icl-rocketry/Engine-Electronics/Chad/Software/README.md

# Ricardo-Gateway
Firmware for Ricardo Gateways
