icl-rocketry/Engine-Electronics/Chad/Hardware/Actuators Board.kicad_pcb

## KiCad design Chad/Hardware/Actuators Board.kicad_pcb (2022-09-09)

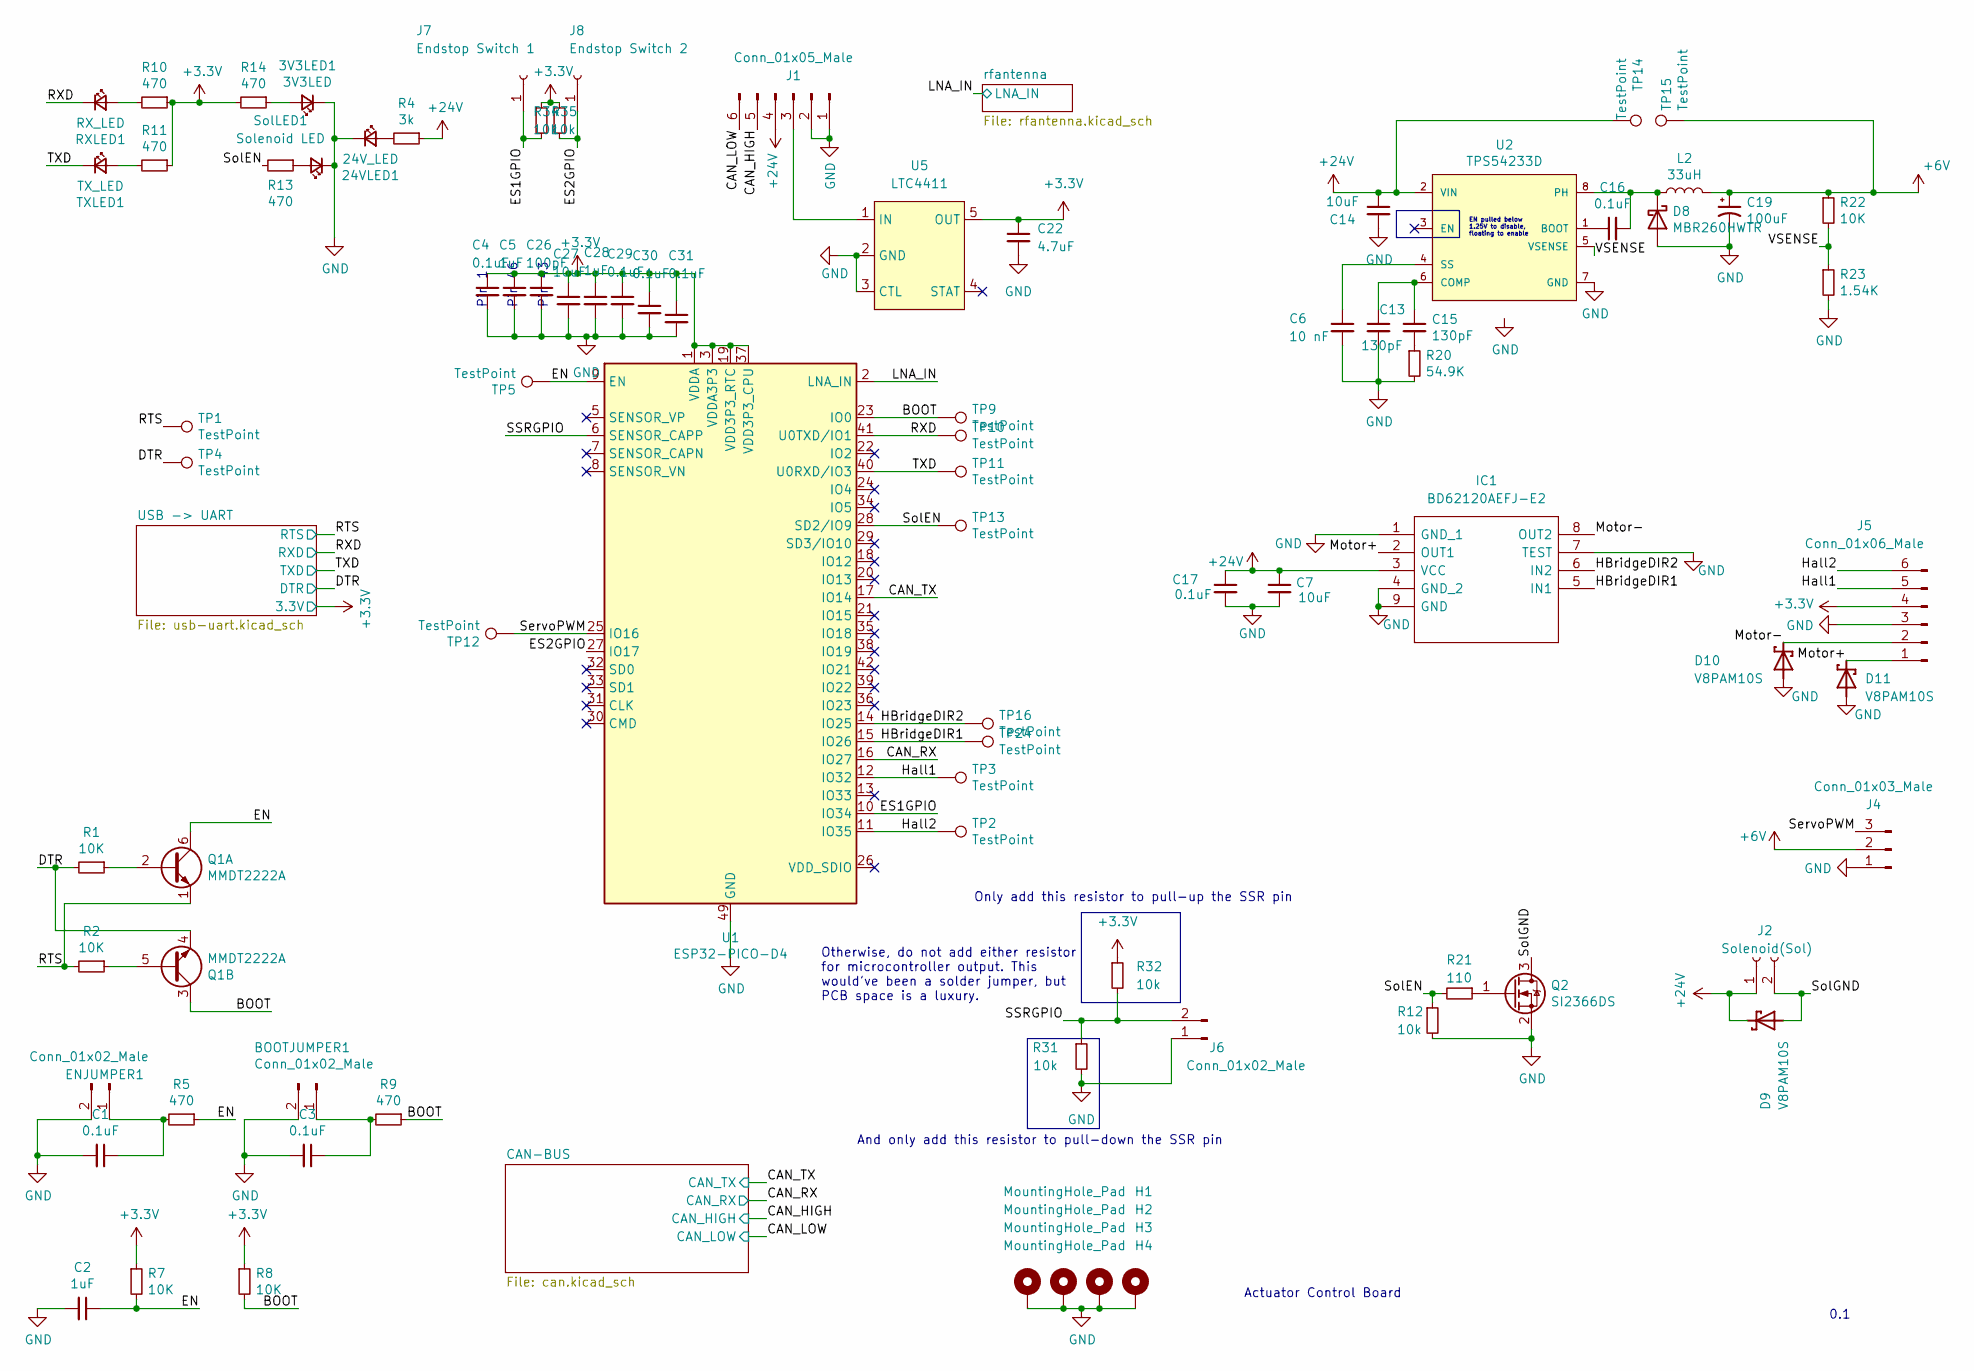
[picture p1: schematic Actuators Board.kicad_sch]

Parts:
3V3LED1: 3V3LED; LED_0603_1608Metric
24VLED1: 24V_LED; LED_0603_1608Metric
BOOTJUMPER1: Conn_01x02_Male; PinHeader_1x02_P2.54mm_Vertical
C1, C3, C4, C16, C17, C29, C30, C31: 0.1uF; C_0603_1608Metric
C2, C5, C28: 1uF; C_0603_1608Metric
C6: 10 nF; C_0603_1608Metric
C7, C14: 10uF; C_1210_3225Metric
C13, C15: 130pF; C_0603_1608Metric
C19: 100uF; CP_Elec_5x5.9
C22: 4.7uF; C_0603_1608Metric
C26: 100pF; C_0603_1608Metric
C27: 10uF; C_0603_1608Metric
D8: MBR260HWTR; D_SOD-123
D9, D10, D11: V8PAM10S; DIO_V3PAN50-M3_I; PARTREV 20-Oct-16
ENJUMPER1: Conn_01x02_Male; PinHeader_1x02_P2.54mm_Vertical
H1, H2, H3, H4: MountingHole_Pad; MountingHole_3.2mm_M3_DIN965_Pad
IC1: BD62120AEFJ-E2; SOIC127P600X100-9N; Manufacturer_Part_Number BD62120AEFJ-E2; Mouser Part Number 755-BD62120AEFJ-E2
J1: Conn_01x05_Male; Molex_Mini-Fit_Jr_5566-06A_2x03_P4.20mm_Vertical
J2: Solenoid(Sol); Molex_Nano-Fit_105309-xx02_1x02_P2.50mm_Vertical
J4: Conn_01x03_Male; Molex_Nano-Fit_105309-xx03_1x03_P2.50mm_Vertical
J5: Conn_01x06_Male; Molex_Nano-Fit_105309-xx06_1x06_P2.50mm_Vertical
J6: Conn_01x02_Male; PinHeader_1x02_P2.54mm_Vertical
J7: Endstop Switch 1; TestPoint_Pad_D1.5mm
J8: Endstop Switch 2; TestPoint_Pad_D1.5mm
L2: 33uH; IND_ETQP5M330YFM
Q1: MMDT2222A; SOT-363_SC-70-6
Q2: SI2366DS; SOT-23
R1, R2, R7, R8, R22: 10K; R_0603_1608Metric
R4: 3k; R_0603_1608Metric
R5, R9, R10, R11, R13, R14: 470; R_0603_1608Metric
R12, R31, R32, R34, R35: 10k; R_0603_1608Metric
R20: 54.9K; R_0603_1608Metric
R21: 110; R_0603_1608Metric
R23: 1.54K; R_0603_1608Metric
RXLED1: RX_LED; LED_0603_1608Metric
SolLED1: Solenoid LED; LED_0603_1608Metric
TP1, TP2, TP3, TP4, TP5, TP9, TP10, TP11, TP12, TP13, TP16, TP24: TestPoint; TestPoint_Pad_D1.0mm
TP14, TP15: TestPoint; TestPoint_Pad_D2.0mm
TXLED1: TX_LED; LED_0603_1608Metric
U1: ESP32-PICO-D4; QFN-48-1EP_7x7mm_P0.5mm_EP5.3x5.3mm
U2: TPS54233D; SOIC127P599X175-8N; Rating Catalog
U5: LTC4411; SOT-23-5

Connections:
+3V3: C4.1, C5.1, C22.1, C26.1, C27.1, C28.1, C29.1, C30.1, C31.1, J5.4, R7.1, R8.1, R10.1, R11.1, R14.2, R32.1, R34.1, R35.1, U1.1 (VDDA), U1.3 (VDDA3P3), U1.4 (VDDA3P3), U1.19 (VDD3P3_RTC), U1.37 (VDD3P3_CPU), U1.43 (VDDA), U1.46 (VDDA), U5.5 (OUT); also elsewhere on the board
+6V: C19.1, J4.2, L2.2, R22.1, TP15.1
+24V: C7.1, C14.1, C17.1, D9.C, IC1.3 (VCC), J1.4, J2.1, R4.1, TP14.1, U2.2 (VIN)
/BOOT: Q1.3 (C2), R8.2, R9.1, TP9.1, U1.23 (IO0)
/CAN_HIGH: J1.5; also elsewhere on the board
/CAN_LOW: J1.6; also elsewhere on the board
/CAN_RX: U1.16 (IO27); also elsewhere on the board
/CAN_TX: U1.17 (IO14); also elsewhere on the board
/DTR: Q1.4 (E2), R1.2, TP4.1; also elsewhere on the board
/EN: C2.1, Q1.6 (C1), R5.1, R7.2, TP5.1, U1.9 (EN)
/ES1GPIO: J7.1, R34.2, U1.10 (IO34)
/ES2GPIO: J8.1, R35.2, U1.27 (IO17)
/HBridgeDIR1: IC1.5 (IN1), TP24.1, U1.15 (IO26)
/HBridgeDIR2: IC1.6 (IN2), TP16.1, U1.14 (IO25)
/Hall1: J5.5, TP3.1, U1.12 (IO32)
/Hall2: J5.6, TP2.1, U1.11 (IO35)
/LNA_IN: U1.2 (LNA_IN); also elsewhere on the board
/Motor+: D11.C, IC1.2 (OUT1), J5.1
/Motor-: D10.C, IC1.8 (OUT2), J5.2
/RTS: Q1.1 (E1), R2.2, TP1.1; also elsewhere on the board
/RXD: RXLED1.1 (K), TP10.1, U1.41 (U0TXD/IO1); also elsewhere on the board
/SSRGPIO: J6.2, R31.1, R32.2, U1.6 (SENSOR_CAPP)
/ServoPWM: J4.3, TP12.1, U1.25 (IO16)
/SolEN: R12.1, R13.2, R21.2, TP13.1, U1.28 (SD2/IO9)
/SolGND: D9.A, J2.2, Q2.3 (D)
/TXD: TP11.1, TXLED1.1 (K), U1.40 (U0RXD/IO3); also elsewhere on the board
/VSENSE: R22.2, R23.1, U2.5 (VSENSE)
GND: 3V3LED1.1 (K), 24VLED1.1 (K), BOOTJUMPER1.2, C1.2, C2.2, C3.2, C4.2, C5.2, C6.2, C7.2, C13.2, C14.2, C17.2, C19.2, C22.2, C26.2, C27.2, C28.2, C29.2, C30.2, C31.2, D8.2 (A), D10.A, D11.A, ENJUMPER1.2, H1.1, H2.1, H3.1, H4.1, IC1.1 (GND_1), IC1.4 (GND_2), IC1.7 (TEST), IC1.9 (GND), J1.1, J1.2, J4.1, J5.3, J6.1, Q2.2 (S), R12.2, R20.2, R23.2, R31.2, SolLED1.1 (K), U1.49 (GND), U2.7 (GND), U5.2 (GND), U5.3 (CTL); also elsewhere on the board
unnamed: 3V3LED1.2 (A), R14.1
unnamed: 24VLED1.2 (A), R4.2
unnamed: BOOTJUMPER1.1, C3.1, R9.2
unnamed: C1.1, ENJUMPER1.1, R5.2
unnamed: C6.1, U2.4 (SS)
unnamed: C13.1, C15.1, U2.6 (COMP)
unnamed: C15.2, R20.1
unnamed: C16.1, U2.1 (BOOT)
unnamed: C16.2, D8.1 (K), L2.1, U2.8 (PH)
unnamed: J1.3, U5.1 (IN)
unnamed: Q1.2 (B1), R1.1
unnamed: Q1.5 (B2), R2.1
unnamed: Q2.1 (G), R21.1
unnamed: R10.2, RXLED1.2 (A)
unnamed: R11.2, TXLED1.2 (A)
unnamed: R13.1, SolLED1.2 (A)

Notes on the sheet:
Pin 1
Pin 46
Only add this resistor to pull-up the SSR pin
Otherwise, do not add either resistor for microcontroller output. This would've been a solder jumper, but PCB space is a luxury.
EN pulled below 1.25V to disable, floating to enable
Pin 43
And only add this resistor to pull-down the SSR pin
0.1
Actuator Control Board

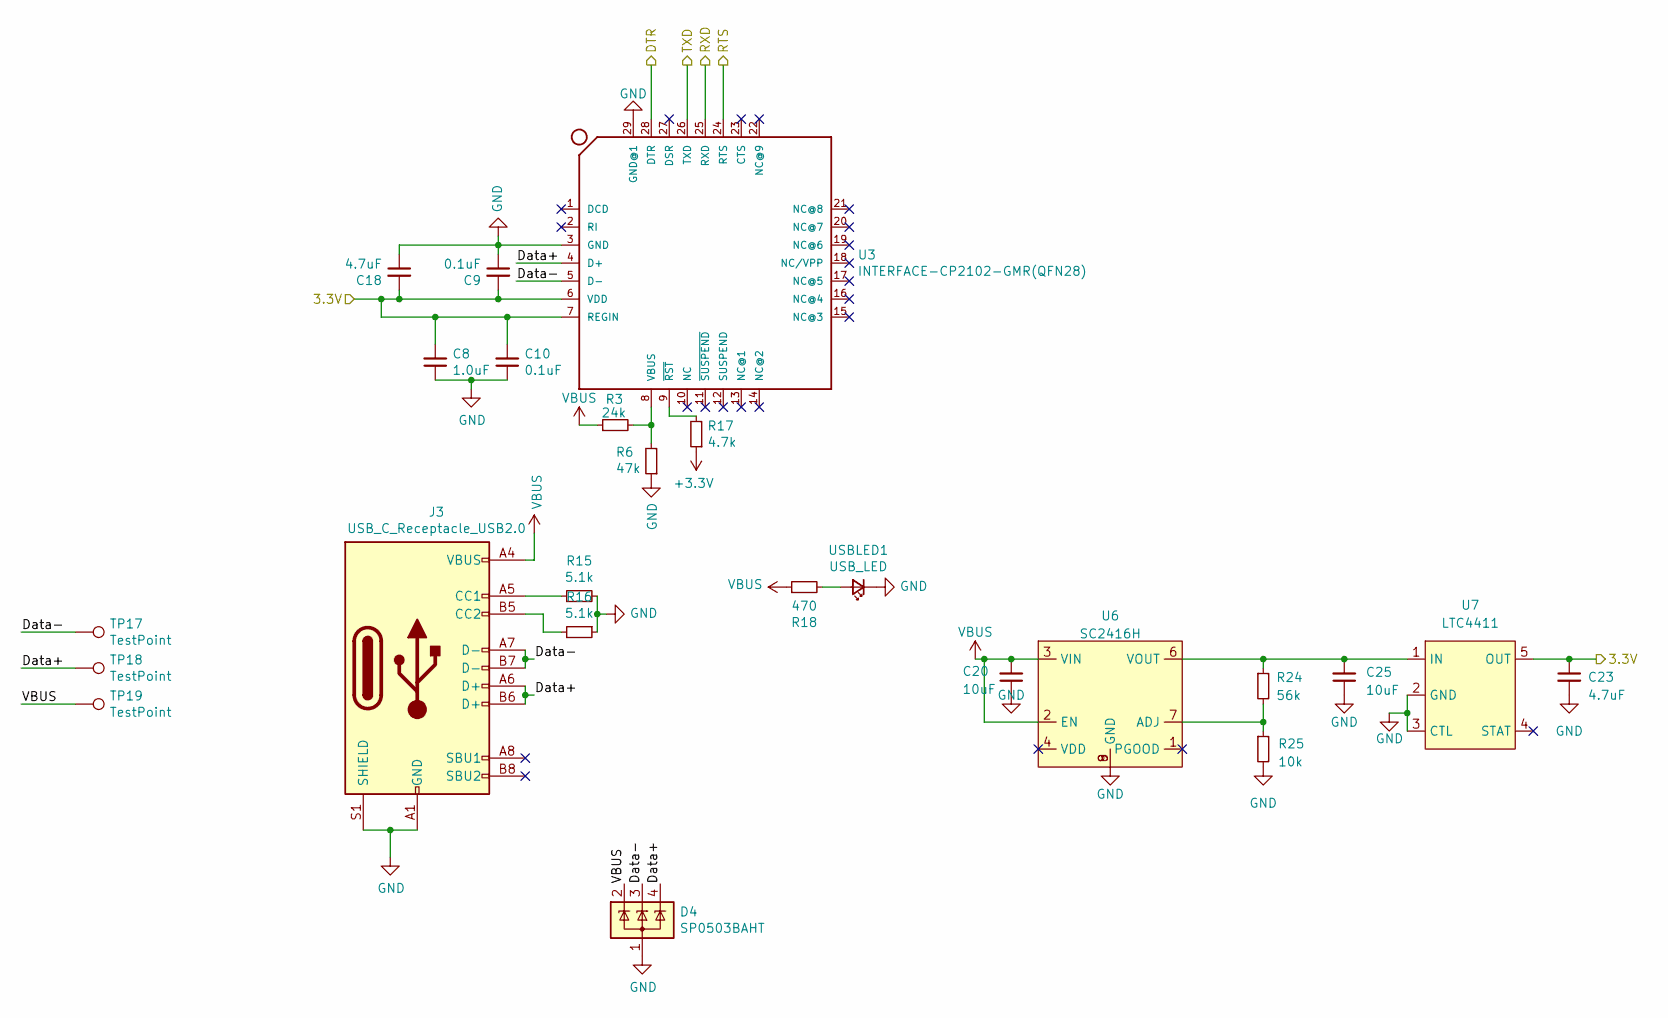
[picture p2: schematic usb-uart.kicad_sch]

Parts:
C8: 1.0uF; C_0603_1608Metric
C9, C10: 0.1uF; C_0603_1608Metric
C18, C23: 4.7uF; C_0603_1608Metric
C20, C25: 10uF; C_0603_1608Metric
D4: SP0503BAHT; SOT-143
J3: USB_C_Receptacle_USB2.0; USB_C_Receptacle_GCT_USB4085
R3: 24k; R_0603_1608Metric
R6: 47k; R_0603_1608Metric
R15, R16: 5.1k; R_0603_1608Metric
R17: 4.7k; R_0603_1608Metric
R18: 470; R_0603_1608Metric
R24: 56k; R_0603_1608Metric
R25: 10k; R_0603_1608Metric
TP17, TP18, TP19: TestPoint; TestPoint_Pad_D1.0mm
U3: INTERFACE-CP2102-GMR(QFN28); QFN28G_0.5-5X5MM; MPN CP2102-GMR
U6: SC2416H; SOIC127P599X175-9N
U7: LTC4411; SOT-23-5
USBLED1: USB_LED; LED_0603_1608Metric

Connections:
+3V3: C8.2, C9.2, C10.2, C18.2, C23.1, R17.1, U3.6 (VDD), U3.7 (REGIN), U7.5 (OUT); also elsewhere on the board
/DTR: U3.28 (DTR); also elsewhere on the board
/RTS: U3.24 (RTS); also elsewhere on the board
/RXD: U3.25 (RXD); also elsewhere on the board
/TXD: U3.26 (TXD); also elsewhere on the board
/USB -> UART/Data+: D4.4 (K), J3.A6 (D+), J3.B6 (D+), TP18.1, U3.4 (D+)
/USB -> UART/Data-: D4.3 (K), J3.A7 (D-), J3.B7 (D-), TP17.1, U3.5 (D-)
GND: C8.1, C9.1, C10.1, C18.1, C20.1, C23.2, C25.1, D4.1 (A), J3.A1 (GND), J3.A12 (GND), J3.B1 (GND), J3.B12 (GND), J3.S1 (SHIELD), R6.1, R15.2, R16.1, R25.2, U3.3 (GND), U3.29 (GND@1), U6.8 (GND), U6.9 (GND), U7.2 (GND), U7.3 (CTL), USBLED1.1 (K); also elsewhere on the board
unnamed: C25.2, R24.1, U6.6 (VOUT), U7.1 (IN)
unnamed: J3.A5 (CC1), R15.1
unnamed: J3.B5 (CC2), R16.2
unnamed: R3.2, R6.2, U3.8 (VBUS)
unnamed: R17.2, U3.9 (~RST)
unnamed: R18.2, USBLED1.2 (A)
unnamed: R24.2, R25.1, U6.7 (ADJ)
VBUS: C20.2, D4.2 (K), J3.A4 (VBUS), J3.A9 (VBUS), J3.B4 (VBUS), J3.B9 (VBUS), R3.1, R18.1, TP19.1, U6.2 (EN), U6.3 (VIN)

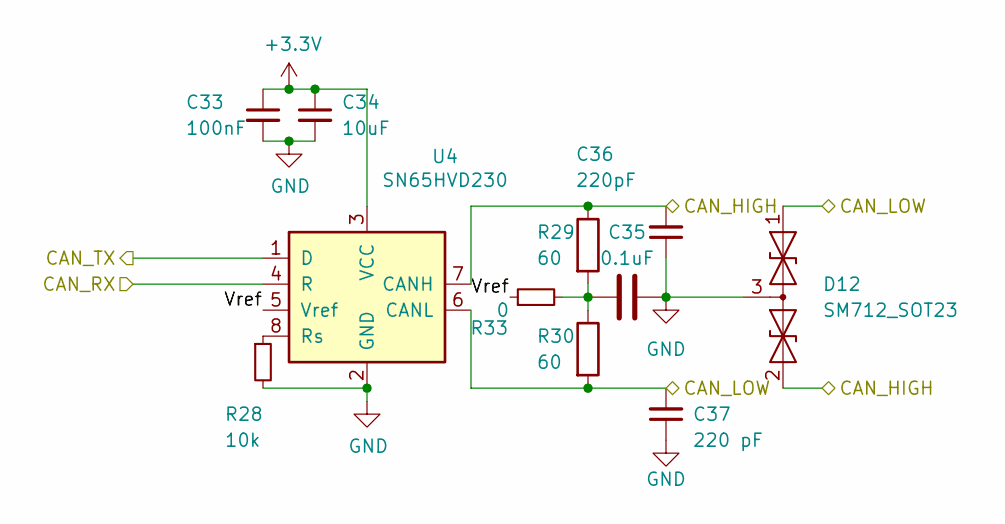
[picture p3: schematic can.kicad_sch]

Parts:
C33: 100nF; C_0603_1608Metric
C34: 10uF; C_0603_1608Metric
C35: 0.1uF; C_0603_1608Metric
C36: 220pF; C_0603_1608Metric
C37: 220 pF; C_0603_1608Metric
D12: SM712_SOT23; SOT-23
R28: 10k; R_0603_1608Metric
R29, R30: 60; R_0603_1608Metric
R33: 0; R_0603_1608Metric
U4: SN65HVD230; SOIC-8_3.9x4.9mm_P1.27mm

Connections:
+3V3: C33.1, C34.1, U4.3 (VCC); also elsewhere on the board
/CAN-BUS/Vref: R33.1, U4.5 (Vref)
/CAN_HIGH: C36.2, D12.2 (A2), R29.1, U4.7 (CANH); also elsewhere on the board
/CAN_LOW: C37.2, D12.1 (A1), R30.2, U4.6 (CANL); also elsewhere on the board
/CAN_RX: U4.4 (R); also elsewhere on the board
/CAN_TX: U4.1 (D); also elsewhere on the board
GND: C33.2, C34.2, C35.2, C36.1, C37.1, D12.3 (common), R28.2, U4.2 (GND); also elsewhere on the board
unnamed: C35.1, R29.2, R30.1, R33.2
unnamed: R28.1, U4.8 (Rs)

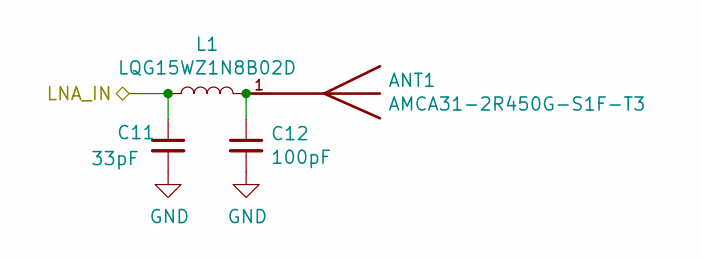
[picture p4: schematic rfantenna.kicad_sch]

Parts:
ANT1: AMCA31-2R450G-S1F-T3; ANT_AMCA31-2R450G-S1F-T3; PARTREV 05.17.2017
C11: 33pF; C_0603_1608Metric
C12: 100pF; C_0603_1608Metric
L1: LQG15WZ1N8B02D; L_0603_1608Metric_Pad1.05x0.95mm_HandSolder

Connections:
/LNA_IN: C11.1, L1.1; also elsewhere on the board
GND: C11.2, C12.2; also elsewhere on the board
unnamed: ANT1.1, C12.1, L1.2

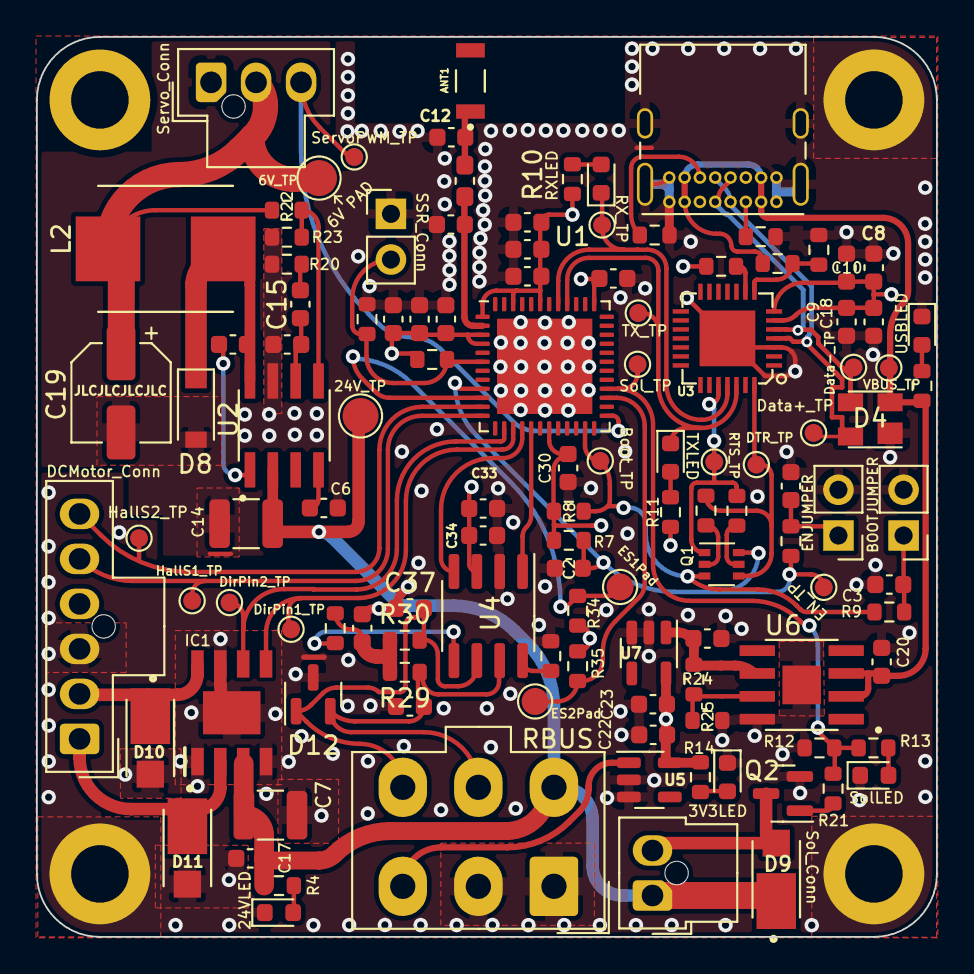
[picture p5: board Actuators Board.kicad_pcb from above]

Board: 4 copper layers, 50.0 x 50.0 mm, 122 parts (0 on the bottom side), 58 nets.
