icl-rocketry/Engine-Electronics/Chad/Software/src/stateMachine.cpp

/* 
Inital State machine framework written by Daniele Bella <3
Code used to process states, and the transitions between them, contains parent class for states

Written by the Electronics team, Imperial College London Rocketry
*/

#include "stateMachine.h"
#include <string>
#include <vector>
#include <functional>

#include "global_config.h"
#include "ricardo_pins.h"

#include "States/state.h"


#include "Network/interfaces/usb.h"

#include "Network/interfaces/canbus.h"

#include "rnp_networkmanager.h"
#include "rnp_default_address.h"

#include "Storage/logController.h"
#include "Storage/systemstatus.h"

#include "SPI.h"
#include "Wire.h"





stateMachine::stateMachine() : 
    I2C(0),
    usbserial(Serial,systemstatus,logcontroller),
    canbus(systemstatus,logcontroller,2),
    networkmanager(5,NODETYPE::HUB,true),
    commandhandler(this),
    logcontroller(networkmanager),
    systemstatus(&logcontroller),
    nrcremoteservo(32,1,networkmanager),
    nrcremotemotor(networkmanager,HBridgeDIR1,HBridgeDIR2,2,3)
{};


void stateMachine::initialise(State* initStatePtr) {

  //internal io initilization must happen here so io buses setup for sensor initialzation
  //intialize i2c interface
  I2C.begin(-1,-1,I2C_FREQUENCY);
  //initalize spi interface
  //open serial port on usb interface
  Serial.begin(Serial_baud);
  Serial.setRxBufferSize(SERIAL_SIZE_RX);

  //setup pins
  pinMode(ES1GPIO,INPUT_PULLUP);
  // pinMode(Hall1,INPUT);
  // pinMode(Hall2,INPUT);

  //setup interfaces
  usbserial.setup();
  canbus.setup();

  //setup network manager so communication is running
  // add interfaces
  networkmanager.addInterface(&usbserial);
  networkmanager.addInterface(&canbus);

  networkmanager.enableAutoRouteGen(true);
  networkmanager.setNoRouteAction(NOROUTE_ACTION::BROADCAST,{1,2});

  nrcremoteservo.setup();
  nrcremotemotor.setup();

   // command handler callback
  networkmanager.registerService(static_cast<uint8_t>(DEFAULT_SERVICES::COMMAND),commandhandler.getCallback()); 
  networkmanager.registerService(10,nrcremoteservo.getThisNetworkCallback());
  networkmanager.registerService(11,nrcremotemotor.getThisNetworkCallback());

  logcontroller.setup();
  networkmanager.setLogCb([this](const std::string& message){return logcontroller.log(message);});


  //call setup state
  changeState(initStatePtr);

  nrcremoteservo.reset();
  
};

void stateMachine::update() {

  networkmanager.update();

  State* newStatePtr = _currStatePtr->update();

  if (newStatePtr != _currStatePtr) {
    changeState(newStatePtr);
  }

  
};

void stateMachine::changeState(State* newStatePtr) {
  // Delete old state instance and change to new one
  if (_currStatePtr != NULL){
    //if not null pointer call exitstate method
    _currStatePtr->exitstate();

  };

  delete _currStatePtr;
  
  _currStatePtr = newStatePtr;
  _currStatePtr->initialise();



};
