icl-rocketry/Engine-Electronics/Chad/Software/include/ricardo_pins.h

/*
**********************
* PINS               *
**********************
 */
#pragma once


static constexpr int TxCan = 14;
static constexpr int RxCan = 27;

// static constexpr int SolEN = 9;

static constexpr int HBridgeDIR2 = 25;
static constexpr int HBridgeDIR1 = 26;

static constexpr int Hall1 = 32;
static constexpr int Hall2 = 35;

static constexpr int ServoPWM = 9;

static constexpr int ES1GPIO = 34;
static constexpr int ES2GPIO = 17;
