icl-rocketry/Engine-Electronics/(commit log)

2021-11-06 Add files via upload
    Open this for the Ricardo clone where we deleted many of the unwanted elements for heating pad control board, and left some space for the new elements
    [Ricardo_updated_clone.sch]
2022-01-29 Added work so far
    [3.sch, battchrg.sch, power_new_25012022.sch]
2022-01-29 Updates changes 29/01/2022
    [3.sch]
2022-02-08 08/02/2022 start
    [power_new_25012022.sch]
2022-02-08 08/02/2022 update
    [3.sch]
2022-02-08 08/02/2022
    3.3v regulators complete
    [3.sch]
2022-02-08 08/02/2022 update3
    [battchrg.sch, power_new_25012022.sch]
2022-02-08 reverse polarity protection
    [3.sch, battchrg.sch, power_new_25012022.sch]
2022-02-13 13/02/2022
    reverse polarity protection added, some test points, general clear up
    [3.sch]
2022-02-19 added lpc/24 enable
    [battchrg.sch, power_new_25012022.sch]
2022-02-22 kicad6 file
    [3.kicad_sch, battchrg.kicad_sch, power_new_25012022.kicad_sch]
2022-02-22 Tidy up Kicad 6
    [3.sch, battchrg.kicad_sch, battchrg.sch, power_new_25012022.sch]
2022-02-26 usb --> uart connection added
    [battchrg.kicad_sch, power_new_25012022.kicad_sch, untitled.kicad_sch]
2022-02-26 Sorted Labels
    [powerboard_sc21_as25.kicad_sch]
2022-02-26 added vbus to 3.3v converter
    [battchrg.kicad_sch, powerboard_sc21_as25.kicad_sch, untitled.kicad_sch]
2022-03-01 Checked the values for battery monitor
    [battchrg.kicad_sch, powerboard_sc21_as25.kicad_sch]
2022-03-05 Added thermistor resistor for specific thermistor
    [battchrg.kicad_sch, powerboard_sc21_as25.kicad_sch, redundantreg.kicad_sch, usb__uart.kicad_sch]
2022-03-08 isolation switch added
    [battchrg.kicad_sch, powerboard_sc21_as25.kicad_sch]
2022-03-25 removed battery monitor
    [battchrg.kicad_sch, battmonitor.kicad_sch, powerboard_sc21_as25.kicad_sch]
2022-05-24 Added connectors and potential divider for charge measurement
    [battchrg.kicad_sch, powerboard_sc21_as25.kicad_sch]
2022-05-24 Swapped remaining p mosfets
    [powerboard_sc21_as25.kicad_sch]
2022-06-04 removed charger reverse polarity protection
    [battchrg.kicad_sch, powerboard_sc21_as25.kicad_pcb, powerboard_sc21_as25.kicad_sch, redundantreg.kicad_sch, usb__uart.kicad_sch]
2022-06-04 changed old mosfets, broke out I2C
    [battchrg.kicad_sch, powerboard_sc21_as25.kicad_sch, redundantreg.kicad_sch, usb__uart.kicad_sch]
2022-06-10 3v3 reg cap & inductor changes, added boost capacitor
    [battchrg.kicad_sch, powerboard_sc21_as25.kicad_sch, redundantreg.kicad_sch, usb__uart.kicad_sch]
2022-06-10 assigned FPs for ceramic caps & most resistors
    [battchrg.kicad_sch, powerboard_sc21_as25.kicad_sch, redundantreg.kicad_sch, usb__uart.kicad_sch]
2022-06-14 added components spreadsheet, changed some caps to ceramic
    [battchrg.kicad_sch, components.xlsx, powerboard_sc21_as25.kicad_sch]
2022-06-14 actually changed caps this time
    [battchrg.kicad_sch, powerboard_sc21_as25.kicad_sch, redundantreg.kicad_sch, usb__uart.kicad_sch]
2022-06-18 All capacitors selected, most other footprints assigned
    [battchrg.kicad_sch, components.xlsx, powerboard_sc21_as25.kicad_sch, redundantreg.kicad_sch, usb__uart.kicad_sch]
2022-06-18 Finished footprint assignment
    [battchrg.kicad_sch, powerboard_sc21_as25.kicad_sch, redundantreg.kicad_sch, usb__uart.kicad_sch]
2022-06-18 changed some FP assignments and imported components
    [battchrg.kicad_sch, powerboard_sc21_as25.kicad_pcb, powerboard_sc21_as25.kicad_sch, redundantreg.kicad_sch]
2022-06-21 grouped components by circuit, done CAN transceiver layout.
    [powerboard_sc21_as25.kicad_pcb, powerboard_sc21_as25.kicad_sch, usb__uart.kicad_sch]
2022-06-27 Tuesday's changes (I don't remember what I did)
    [powerboard_sc21_as25.kicad_pcb]
2022-06-28 Finalised buck capacitors, some inital layout
    [components.xlsx, powerboard_sc21_as25.kicad_pcb, powerboard_sc21_as25.kicad_sch, redundantreg.kicad_sch]
2022-06-28 moving around charger components
    [battchrg.kicad_sch, powerboard_sc21_as25.kicad_pcb]
2022-07-04 changed isolation switch position
    [powerboard_sc21_as25.kicad_pcb]
2022-07-04 started routing, mess at the moment
    [powerboard_sc21_as25.kicad_pcb]
2022-07-06 change some passive values and slight FP changes after orderlist
    some resistor values were really unconventional and some cap footprints had gone out of stock so had to change them.
    [battchrg.kicad_sch, powerboard_sc21_as25.kicad_sch, redundantreg.kicad_sch, usb__uart.kicad_sch]
2022-07-06 forgot to stage the footprint info file
2022-07-06 layout progress
    [battchrg.kicad_sch, powerboard_sc21_as25.kicad_pcb, powerboard_sc21_as25.kicad_sch, usb__uart.kicad_sch]
2022-07-07 Fixed USB data pins
    [powerboard_sc21_as25.kicad_sch, usb__uart.kicad_sch]
2022-07-07 Changed some values and footprints since some went out of stock
    [battchrg.kicad_sch, powerboard_sc21_as25.kicad_sch, redundantreg.kicad_sch, usb__uart.kicad_sch]
2022-07-08 Change RSR and RAC sense resistor to ones rated for 5W
    [battchrg.kicad_sch, powerboard_sc21_as25.kicad_sch]
2022-07-08 changed RSR again
    [battchrg.kicad_sch, powerboard_sc21_as25.kicad_sch]
2022-07-08 update 2
    [powerboard_sc21_as25.kicad_pcb, powerboard_sc21_as25.kicad_sch]
2022-07-08 changed RSR traces to same layer
    going to check charger layout recommendations again
    [powerboard_sc21_as25.kicad_pcb]
2022-07-10 Andrei's review, no via fencing on ufl conn
    [powerboard_sc21_as25.kicad_pcb]
2022-07-11 corrected based on bq24618 guidelines as much as possible
    [powerboard_sc21_as25.kicad_pcb]
2022-07-14 Removed CAN resistors
    [powerboard_sc21_as25.kicad_pcb, powerboard_sc21_as25.kicad_sch]
2022-07-17 Added connector for PDU EN pin and external LED + routing changes
    [powerboard_sc21_as25.kicad_pcb, powerboard_sc21_as25.kicad_sch]
2022-07-19 silkscreen tidying
    [powerboard_sc21_as25.kicad_pcb]
2022-07-23 swapping mosfets the right way around
    [battchrg.kicad_sch, powerboard_sc21_as25.kicad_pcb, redundantreg.kicad_sch]
2022-07-23 super small adjustment
    [powerboard_sc21_as25.kicad_pcb]
